Apoorva64/ArduinoProject1/README.md

# Ping Pong Trainer

Diagramme de gantt : [diagramme de gantt](https://github.com/Apoorva64/Ping-Pong-Trainer/blob/main/documentation/diagramme%20de%20gantt.xlsx)
Cahier de charges : [cahier de charges](https://github.com/Apoorva64/Ping-Pong-Trainer/blob/main/documentation/Cahier%20de%20charge.docx)
