Apoorva64/ArduinoProject1/compte_rendus/BURDESE Yael/7-BURDESE.md

# Septième séance

## collage et montage du cannon

on a fini de monter le canon et tester le tir qui fonctionne bien. Sinon pour la cadence le dispositif avec le servomoteur devrait faire l'affaire.

## création du code

on a utilisé visual studio code avec le plugin platformio pour pouvoir coder notre programme pour controler le cannon avec le bluetooth.
J'ai commencé la partie cannon et controle du servomoteur pour le tir, il ne manque plus qu'à ajuster les valeurs pour le tennis de table.
