Apoorva64/ArduinoProject1/compte_rendus/BURDESE Yael/5-BURDESE.md

# Cinquième séance

## création du tube du cannon

J'ai construit le tube en plastique qui servira de canon pour les balles de ping pong, avec les encoches pour les moteurs.
j'ai ensuite adapté la maquette en lego pour accueillir le tube et le tout fonctionne.

## fabrication de la structure qui maintient le tube du cannon
Utilisation du logiciel inkscape pour dessiner la base dans laquelle il y aura les moteurs et le tube qui viendra remplacer la maquette en lego.
