Apoorva64/ArduinoProject1/compte_rendus/BURDESE Yael/3-BURDESE.md

# Troisième séance

## branchement des moteurs du canon sur l'arduino
cablage du module moteur sur l'arduino avec tests des moteurs
on observe un problème au niveau d'une des deux roues car la liaison entre la roue et le moteur n'est pas optimale(patte à fixe oblige) donc la roue ne reste pas perpendiculaire

## recherche et découpage des pièces de la base du canon
récupération des pièces en bois et découpage des pièces selon les dimensions choisies
mesures pour percer les pièces de bois
