Apoorva64/ArduinoProject1/compte_rendus/BURDESE Yael/2-BURDESE.md

#   Deuxième séance

## modélisation 3d du canon et de la magazine

J'ai modélisé le canon et la magazine pour l'impression 3D mais aussi pour avoir une idée des dimensions que je voulais pour le canon et comment placer les moteurs.
Après réflexion, j'ai décidé de ne pas imprimer en 3D et d'utiliser les tube en cartons disponibles.



## choix principaux
j'ai choisi de prendre une base sur laquelle je fixerais le canon dans laquelle je pourrais encastrer les moteurs. 


Pour le débit des balles je ne sais pas encore si je fais une roue comme dans un moulin qui serait à l'intérieur de la courbure ou si je fais comme sur le modèle 3D une roue qui laisse ou non passer les balles.



Pour les dimensions la hauteur du canon avec la magazine serait de 30 cm avec la base et l'entonnoir autour de 40 cm, pour la longueur autour de 20 cm et pour la largeur 10 cm au total. 

## Mise à jour
