Apoorva64/ArduinoProject1/compte_rendus/BURDESE Yael/1 -BURDESE.md

# Première séance

## dernière définition de notre projet

On a choisi la forme finale de notre projet. On a choisi de le faire se déplacer horizontalement sur la largeur de la table de ping pong avec un axe.
On a réfléchi a faire un robot qui se déplace sur la table mais on a pensé que ce serait plus compliqué pour gérer les programmes d'entrainement à la fin du projet.

## calcul et choix des dimensions

je me suis occupé de la partie canon et chargeur.
Pour le chargeur il sera en forme d'entonnoir avec un tube qui un rayon un peu plus grand celui d'une balle.
2 moteur continu pour lancer les balles et donner des effets .
1 moteur pour gérer le débit de balles avec un plateau qui laisse passer ou non les balles.
J'ai pris une vitesse de propulsion de 15 m/s et un rayon de 4.5cm pour le tube


## préparation de la modélisation 3D

installation et débur d'apprentissage du logiciel freeCad.

## Mise à jour
On a finalement vu que la licence que l'on avait obtenu l'année dernière pour le logiciel onShape était toujours active donc comme nous avions passer 1 semestre à utiliser ce logiciel, nous avons décidé de retourner dessus pour la modélisation pour ne pas avoir à rechercher des fonctionnalitées.
