Apoorva64/ArduinoProject1/compte_rendus/Apoorva Appadoo/4-Appadoo-Apoorva.docx

# Rapport séance 4

# Construction de l’étage 0 :

Pendant cette séance j’ai continué la construction du premier étage de la base du Cannon. J’ai construit la plaque coulissante et j’ai trouvé le moyen de fixer le stepper moteur sur la plaque.

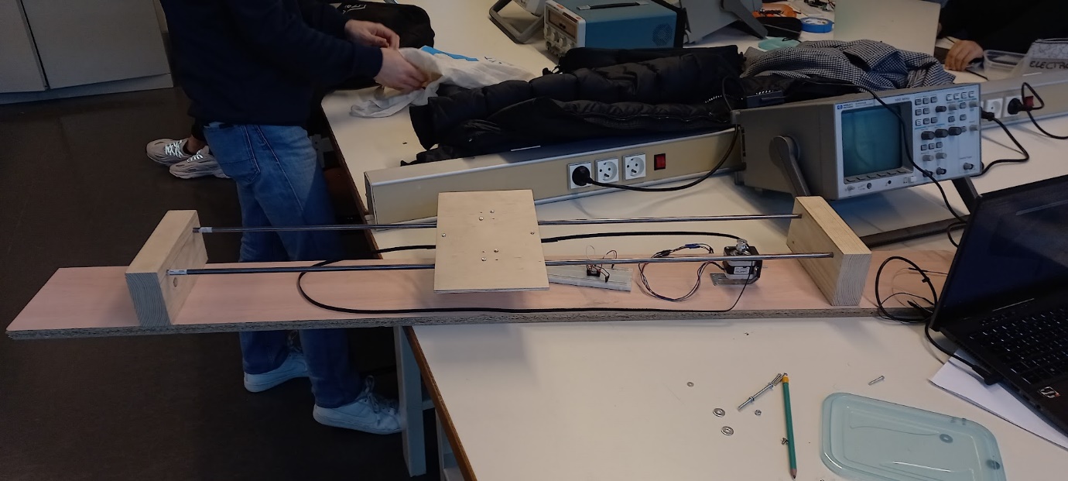
[picture p3: figure]

Problèmes rencontrés :

- La fixation du moteur stepper sur la planche de bois n’était pas évident car il n’y a pas de fixations au bas du moteur il a fallu utiliser 2 connecteurs en aluminium pour pouvoir le fixer.
- La liaison entre l’étage 0 et les rails étaient problématique en effet, le perçage des trous n’a pas été parfaitement parallèle donc il a fallu passer du temps pour que la plaque glisse convenablement

# Progrès sur la modélisation de l’étage 1 du Cannon

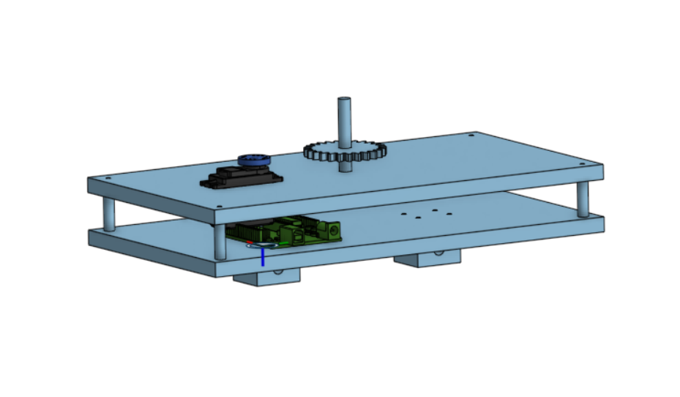
[picture p4: figure]
