Apoorva64/ArduinoProject1/compte_rendus/Apoorva Appadoo/Vacances.docx

# Vacances

# I. Familiarisation avec le moteur stepper

## a. Réglages du contrôleur

Le contrôleur est le A4988. Il peut lui, donner 1A en continue tandis que notre moteur ne peut prendre que 0.6A en continu. Il faut donc régler la limite de courant.

En utilisant la formule :

On a ici Rcs=0.068 Ω

Current Limit = (V_(ref))/(8 × Rcs)

Current Limit*(8 × Rcs) = V_(ref)

V_(ref) =0.6*8*0.068

V_(ref) =0.32 V

J’ai par la suite réglé le contrôleur pour atteindre le V_(ref)

## b. Tests

J’ai tout câblé et j’ai commené à faire des tests.

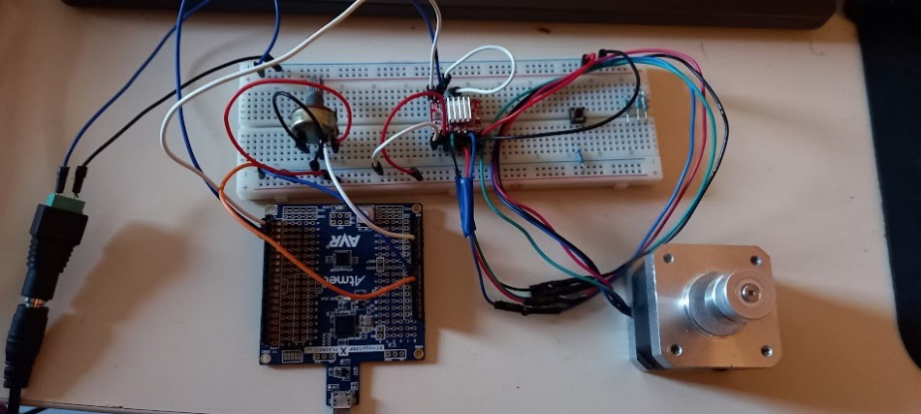
[picture p5: figure]

En effet j’ai commencé par chercher le nombre de pas pour une rotation, qui est de 800 pas. Par la suite grace à un potentiomètre j’ai cherché une vitesse ou le moteur n’était pas trop entrain de mourir. Ce qui est d’environ 150 RPM.
