Apoorva64/ArduinoProject1/compte_rendus/Apoorva Appadoo/2-Appadoo-Apoorva.docx

# Rapport de séance du 1/12/2021

# 1. Modélisation de la plateforme de translation du Cannon

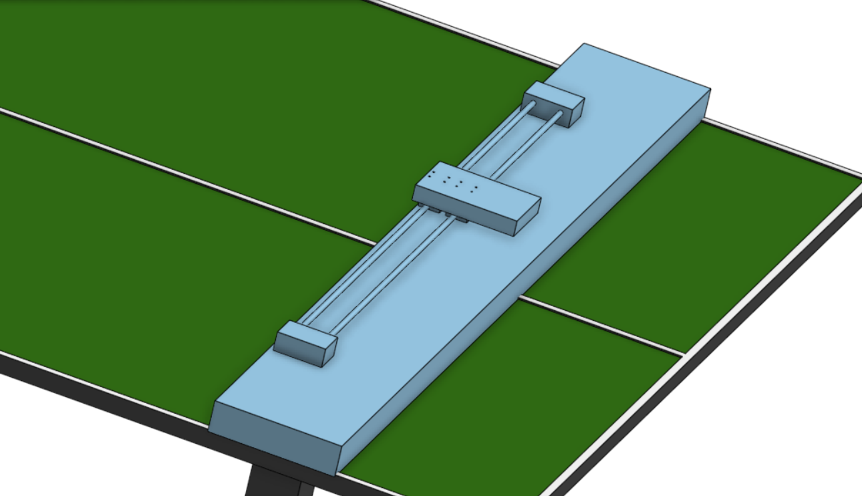
[picture p7: figure]

Pendant cette séance j’ai modélisé la base du Cannon.

Le système est une plaque qui glisse sur des rails comme on le voit sur l’image. Les rails sont fixés à une planche de bois qui sera posée sur la table. Cette plaque sera reliée à une courroie qui sera elle relie à un moteur stepper. Je n’ai pas encore modélisé la courroie dans le modèle.

J’ai modélisé pour avoir une idée des dimensions nécessaires pour notre projets cela m’as aussi permis de comprendre plus précisément la liste de matériaux nécessaires à notre projet.

On a décidé que la plupart de la structure sera faite en bois sauf les rails de 1 mètres qui sont en métal et qu’on utilisera des vis pour relier les différentes parties ensembles.

Lien du model :

https://cad.onshape.com/documents/02b74bf3ca665f311ca72f86/w/3df40694f696c61102bae216/e/902f95623bffb6c378552ca1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

# 2. Matériel

J’ai parlé avec le prof pour me procurer le matériel suivant

- Moteur stepper nema 17
- Controller du moteur stepper
- Alimentation 12v
- Courroie
- Pigions

# 3. Familiarisation avec le moteur Nema 17

J’ai commencé à lire le PDF du prof sur le fonctionnement des moteurs stepper.
