Apoorva64/ArduinoProject1/compte_rendus/BURDESE Yael/8-BURDESE.md

#  Huitième séance

## ajustement des valeurs et tests sur le mur

le tir du canon fonctionne comme prévu, c'est meme plus précis que ce que je pensais au départ.
Les effets sont bon, la gestion de la vitesse fonctionne et les déplacements sont bon.
On va rajouter des roues sur les cotés du canon pour le solidifier.

## création de programmes prédéfinis
on a créer des fonctions dans le code pour pouvoir tirer selon des paramètres prédéfini et non avoir a commandé la machine avec son téléphone, il suffit de lancer le programme et il se fait seul.
