Apoorva64/ArduinoProject1/compte_rendus/BURDESE Yael/6-BURDESE.md

# Sixième séance

## création support du canon

modification du modèle sur inkscape pour la fabrication du support pour la découpe laser et consrtuction du support.




## modification des modèles 3d
J'ai modifié le modèle 3d de la pièce qui permet de gérer l'angle sur la hauteur de tir du canon car j'avais besoin d'une encoche pour laisser passer le levier qui gère la cadence

## préparation du montage final et tests du bluetooth avec Apoorvah
on a rassembler les pièces de la base pour tester les mouvements avec le bluetooth
