Apoorva64/ArduinoProject1/compte_rendus/BURDESE Yael/4-BURDESE.md

# Quatrième séance

## création d'une maquette et début du code arduino pour le tir

J'ai construit une maquette à l'aide de lego pour pouvoir tester les différents mode de tir et la vitesse des balles.
Pour l'instant, pour ce qui est de la vitesse et de l'effet, les moteurs semblent fonctionner, par contre il y a un problème avec le moteur droit.
Il ne tourne pas dans le sens inverse pour mettre une rotation à droite, il s'agit soit d'un des transistors du pont en H qui est défectueux soit de l'un de mes branchements.
