Apoorva64/ArduinoProject1/robot_parts/PLACEHOLDER.md

# This directory will contain the parts of the robot
