Apoorva64/ArduinoProject1/code/ping pong trainer/src/CannonController/CannonController.hpp

#ifndef CANNON_CONTROLLER_H
#define CANNON_CONTROLLER_H
#include <Arduino.h>

class CannonController
{
public:
    int enablePin1;
    int motor1Pin1;
    int motor1Pin2;
    int enablePin2;
    int motor2Pin1;
    int motor2Pin2;
    CannonController();
    CannonController(int enablePin1,
                     int motor1Pin1,
                     int motor1Pin2,
                     int enablePin2,
                     int motor2Pin1,
                     int motor2Pin2);
    ~CannonController();
    void updateMotor(double speed, double spin);
};
#endif
