Apoorva64/ArduinoProject1/(commit log)

2021-11-30 -added cahier de charges and added diagramme de gantt to the project - created folder structure to add compte rendus
    [diagramme de gantt.xlsx]
2021-12-01 update seance 1 cahier de charges
2021-12-16 added cahier de charge for "seance 2"
2021-12-22 added rapport de seance vacances
2021-12-24 added code with platformio framework
2022-01-06 updated diagramme de gantt.xlsx
    [diagramme de gantt.xlsx]
2022-01-13 added rapport de seance 4
2022-02-01 added rapport de seance 5
2022-02-08 updated rapport - fixed pins for the robot - fixed stepper callibration
    [YAxisController.cpp, main.cpp, robot.hpp]
